CyberChic7/EDL_Documentation/others/images/IMG-20260407-WA0089.jpg

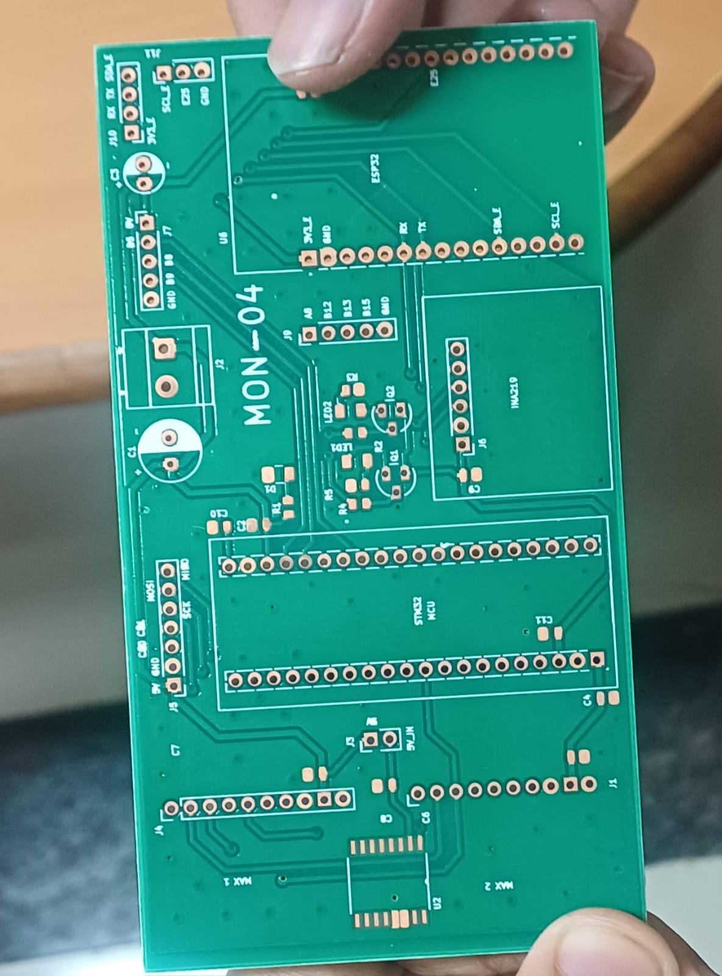
others/images/IMG-20260407-WA0089.jpg
