CyberChic7/EDL_Documentation/others/images/IMG-20260407-WA0267.jpg

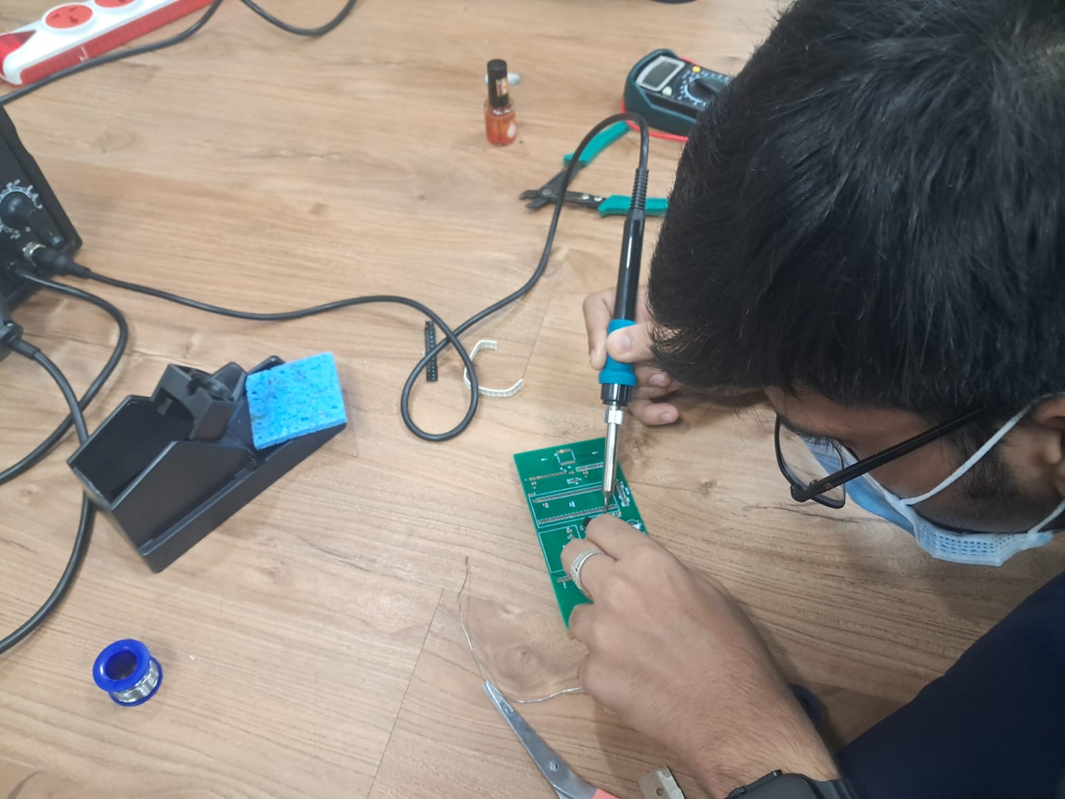
others/images/IMG-20260407-WA0267.jpg
