CyberChic7/EDL_Documentation/others/images/README.md

This folder contains images of the PCB, its CAD model, the soldering done, the printed box for our device, along with the final assembled device.
