CyberChic7/EDL_Documentation/reports/MON-04-M0.pdf

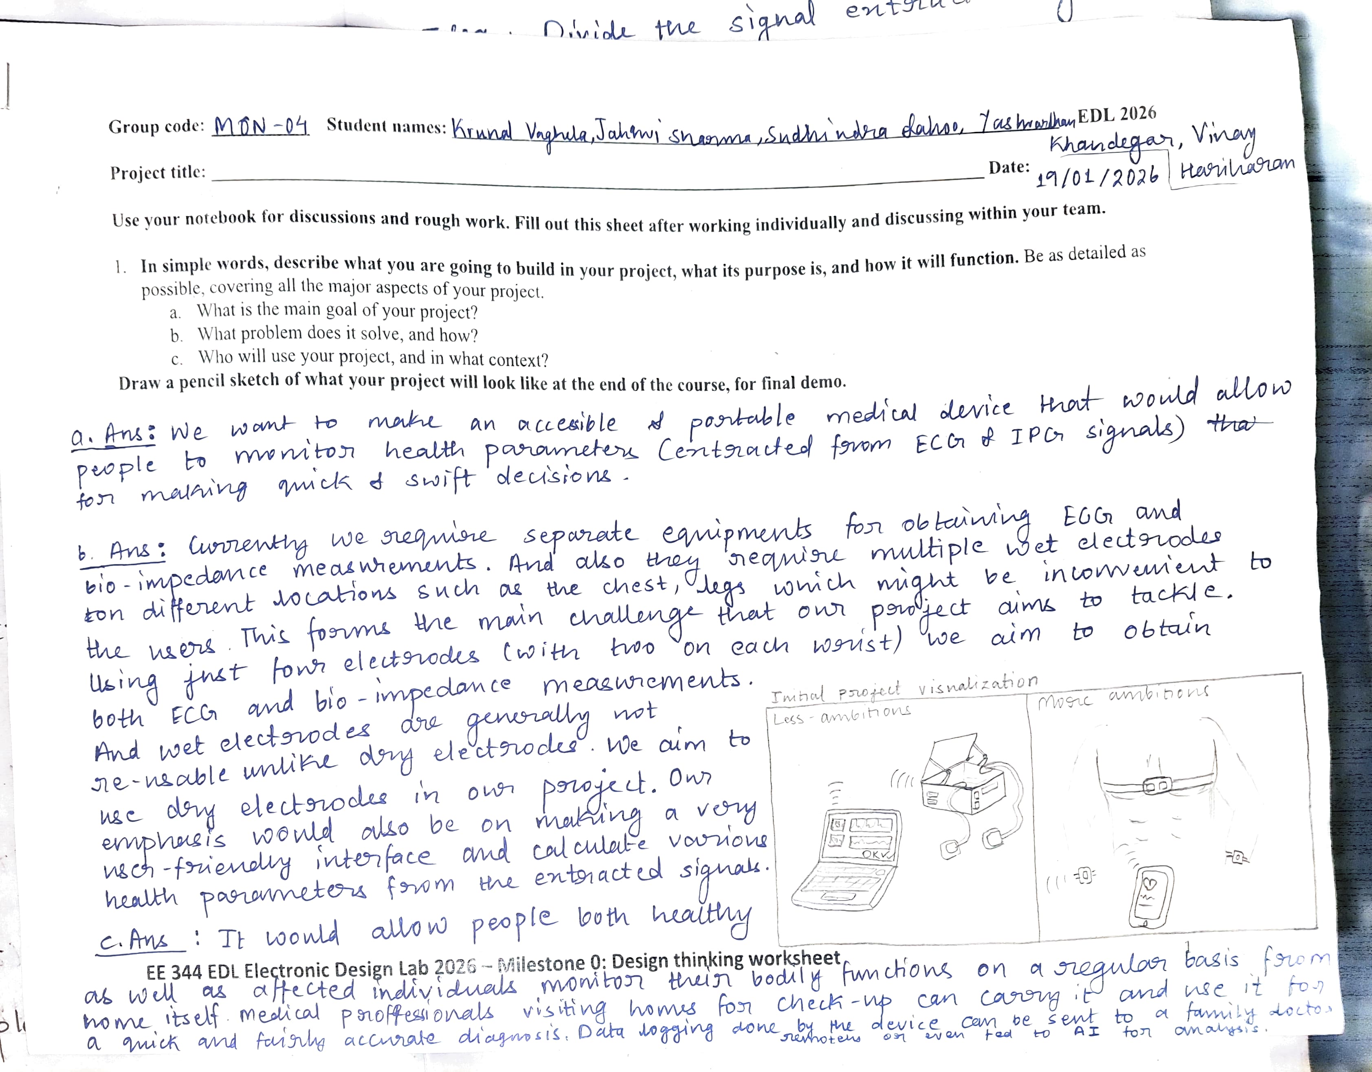
[picture p15: page 1]
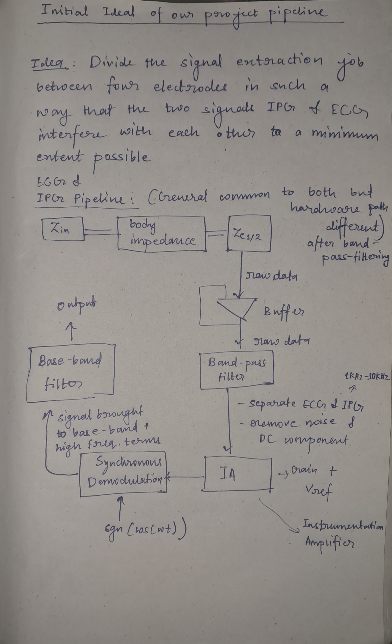
[picture p16: page 2]
