CyberChic7/EDL_Documentation/others/images/IMG-20260409-WA0015.jpg

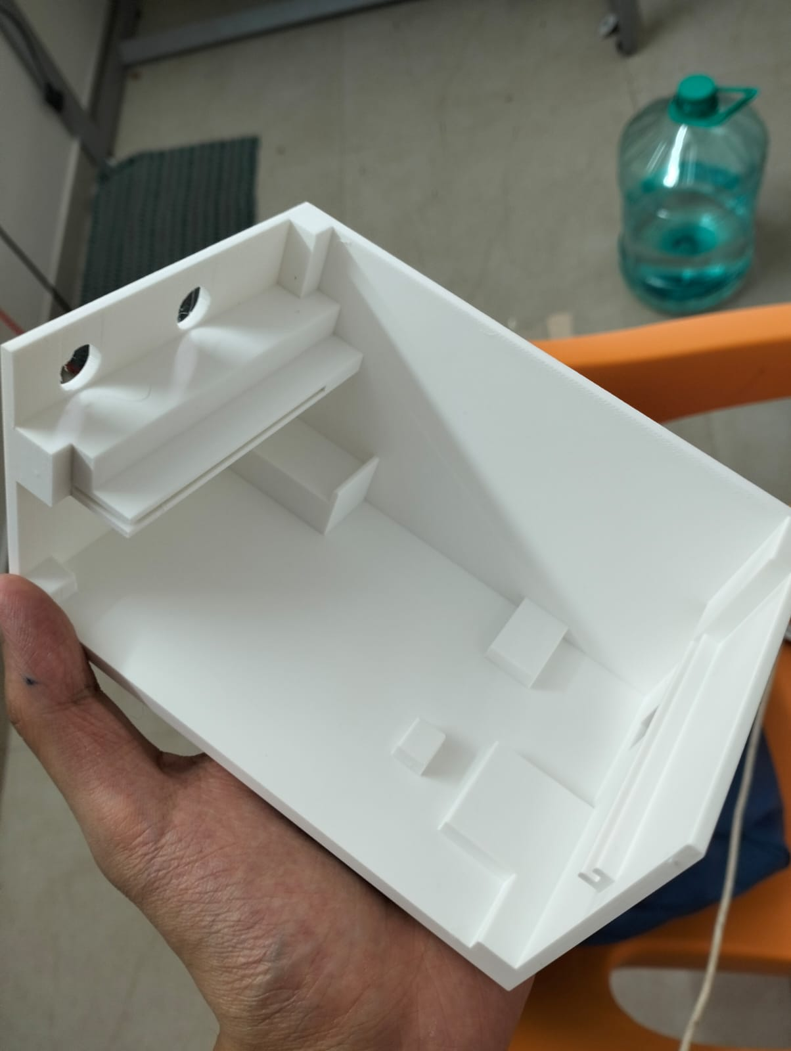
others/images/IMG-20260409-WA0015.jpg
