CyberChic7/EDL_Documentation/others/images/IMG-20260411-WA0047.jpg

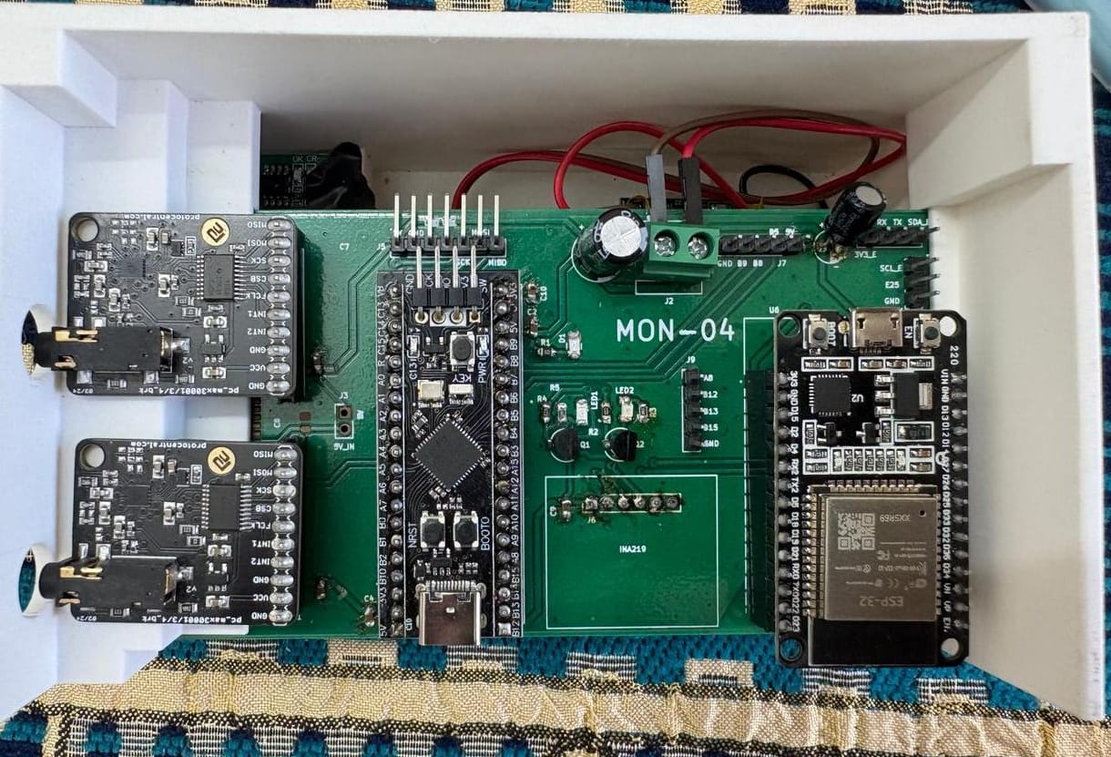
others/images/IMG-20260411-WA0047.jpg
