CyberChic7/EDL_Documentation/others/images/IMG-20260415-WA0019.jpg

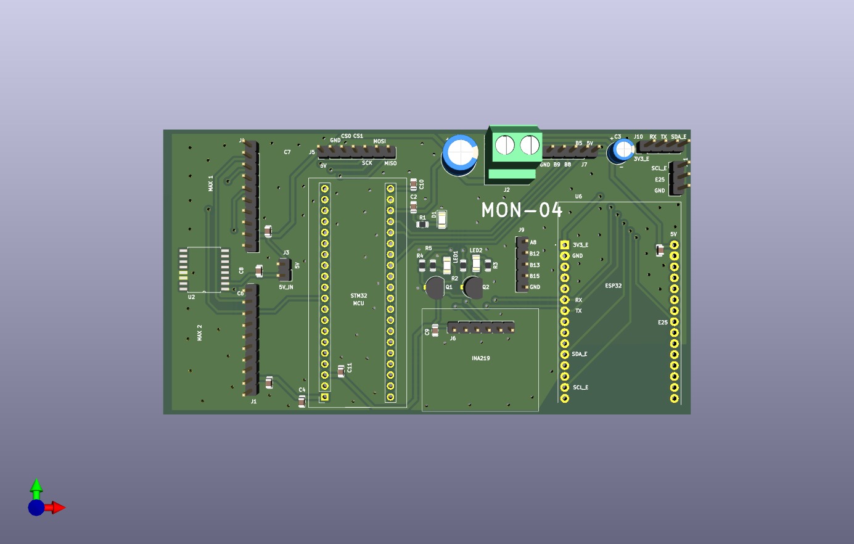
others/images/IMG-20260415-WA0019.jpg
