CyberChic7/EDL_Documentation/others/images/IMG-20260415-WA0020.jpg

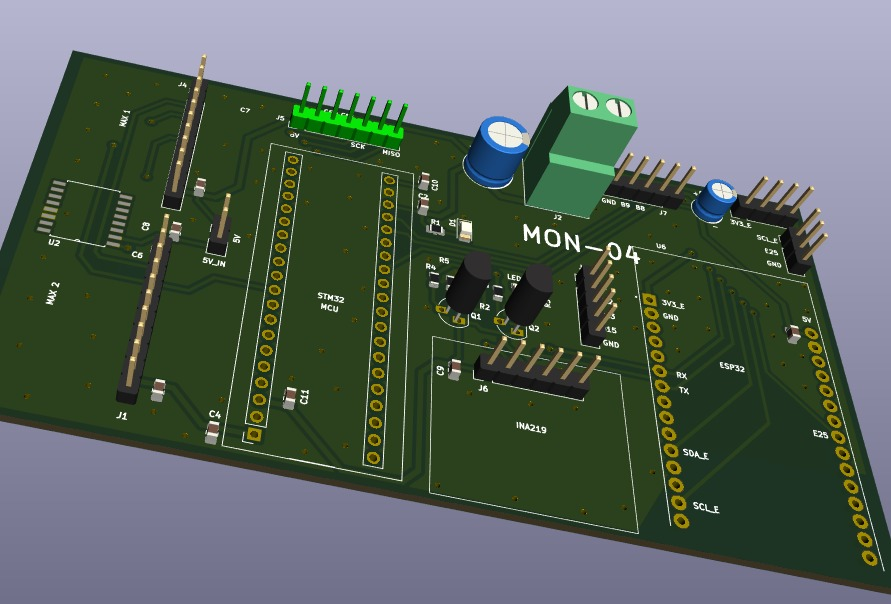
others/images/IMG-20260415-WA0020.jpg
