CyberChic7/EDL_Documentation/others/images/WhatsApp Image 2026-04-11 at 19.59.58.jpeg

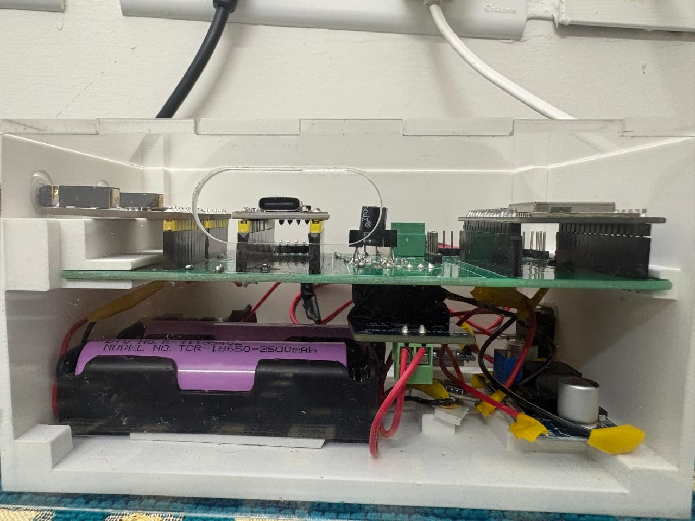
others/images/WhatsApp Image 2026-04-11 at 19.59.58.jpeg
