CyberChic7/EDL_Documentation/others/simulation/IMG-20260411-WA0053.jpg

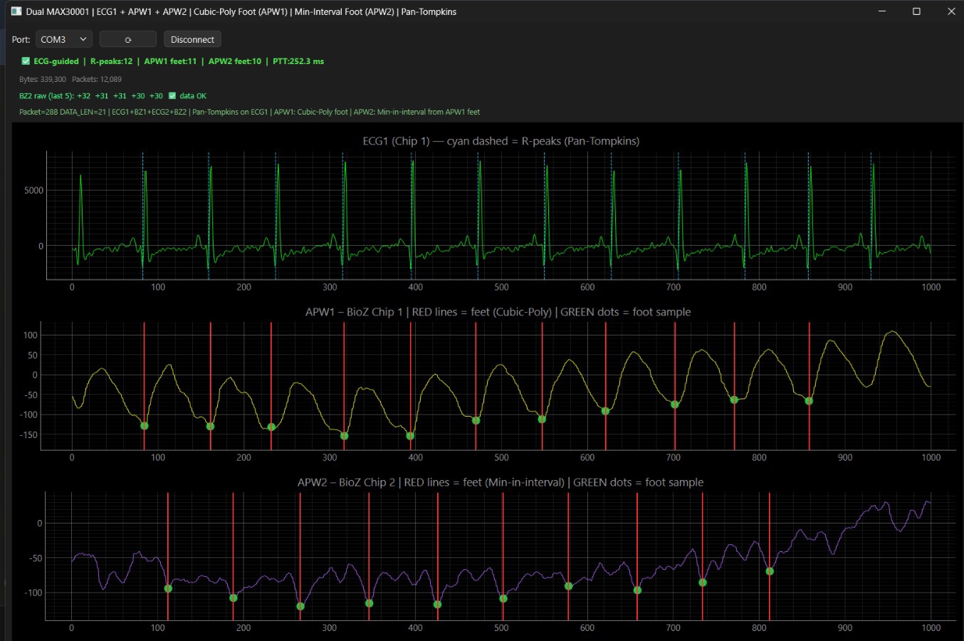
others/simulation/IMG-20260411-WA0053.jpg
