CyberChic7/EDL_Documentation/(commit log)

2026-04-14 File upload - black pill firmware
    Initial commit of the firmware for the Dual MAX30001 on STM32F411 Black Pill.
2026-04-14 Add README.md for STM32F411 Black Pill firmware
    Added detailed firmware documentation for STM32F411 Black Pill, including platform specifications, role in the system, hardware connections, firmware overview, DSP pipeline, and packet format.
2026-04-14 Add setup guide for STM32F411 Black Pill
    Added a comprehensive setup guide for the STM32F411 Black Pill, detailing installation of the Arduino IDE, STM32 board support, required libraries, hardware setup, firmware compilation, flashing, and troubleshooting steps.
2026-04-14 Add README for the ESP32 subfolder
    Added detailed README for ESP32 wireless bridge project, including platform details, system role, hardware connections, design decisions, configuration, key parameters, and serial monitor output.
2026-04-14 Add environment setup guide for ESP32
    Added a comprehensive environment setup guide for the ESP32, covering installation of Arduino IDE, board support, Wi-Fi configuration, flashing process, and troubleshooting tips.
2026-04-15 Add user manual for IM-PULSE device
    Added comprehensive user manual for the IM-PULSE device, detailing its features, hardware overview, usage instructions, troubleshooting, and maintenance.
